Miceuz/leds-got-waxed/pics/20151221_044.jpg

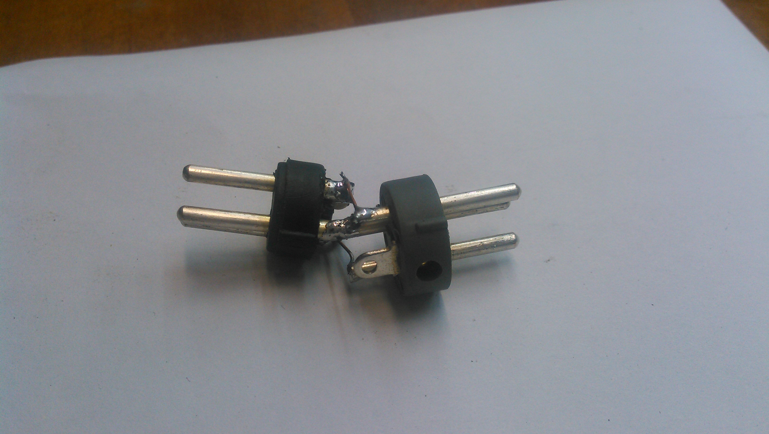
pics/20151221_044.jpg
