Miceuz/leds-got-waxed/20151120_155648.jpg

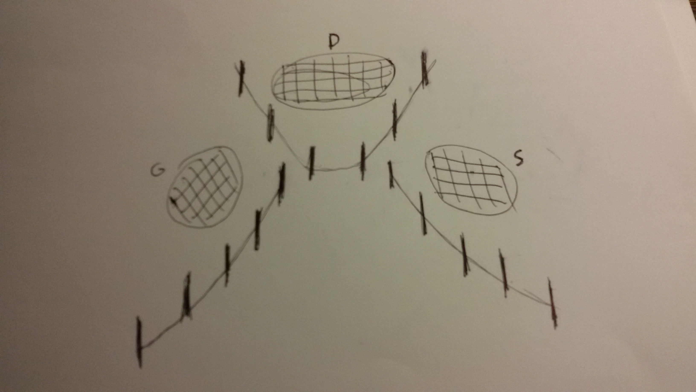
20151120_155648.jpg
