Miceuz/leds-got-waxed/README.md

# leds-got-waxed

A LED based effect box for a music band.
mess on a table

Full writeup is available here: http://wemakethings.net/2015/12/25/leds-got-waxed/
