Miceuz/leds-got-waxed/audio-channel.png

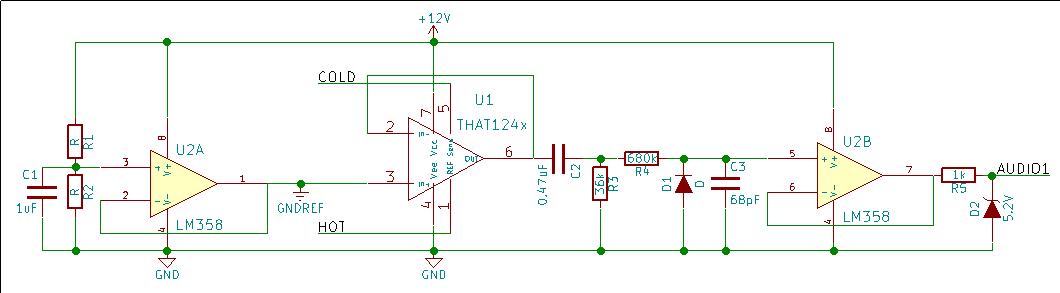
audio-channel.png
