Miceuz/leds-got-waxed/doc/PDS4.jpg

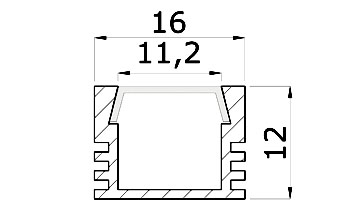
doc/PDS4.jpg
