Miceuz/leds-got-waxed/foot.png

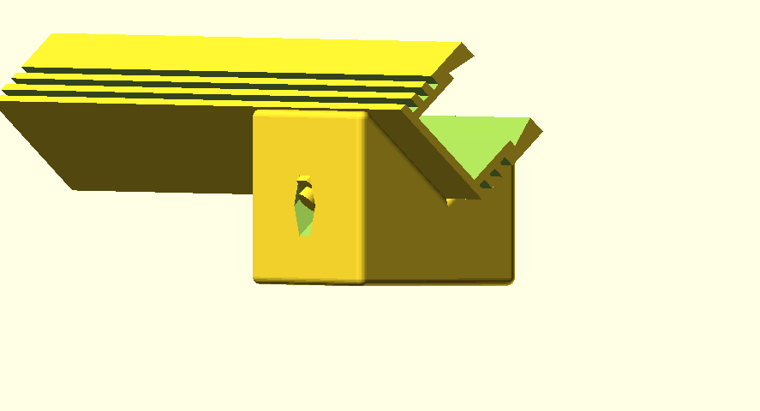
foot.png
