Miceuz/leds-got-waxed/multiplexer_cascade.png

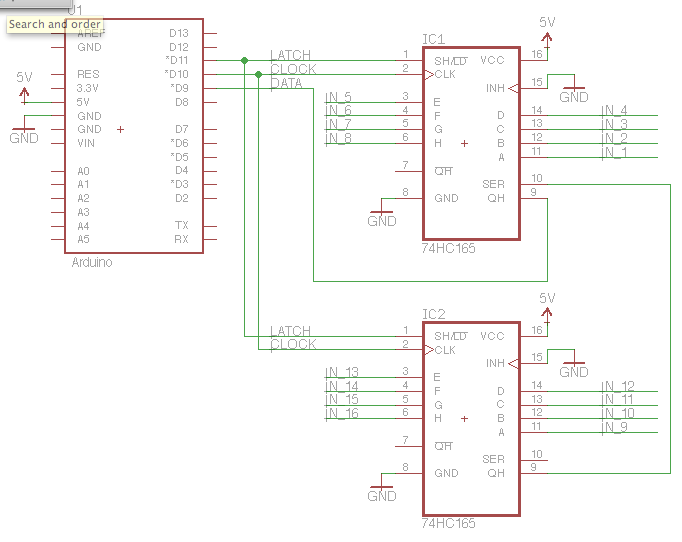
multiplexer_cascade.png
