Miceuz/leds-got-waxed/pics/20151221_002.jpg

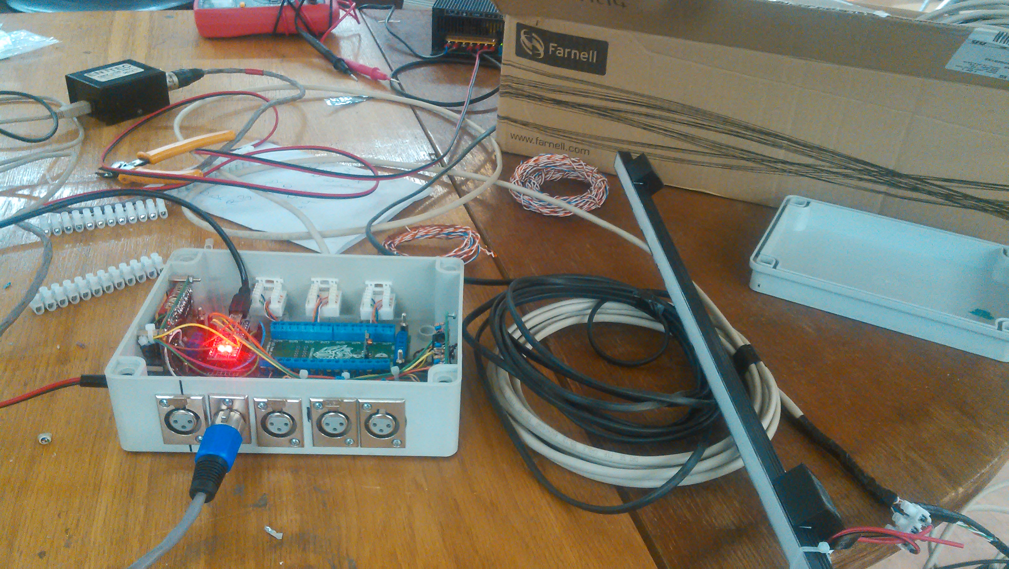
pics/20151221_002.jpg
