Miceuz/leds-got-waxed/pics/20151221_024.jpg

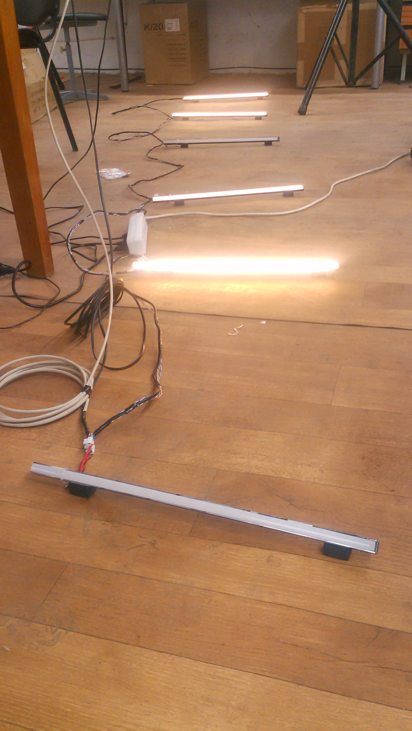
pics/20151221_024.jpg
