Miceuz/leds-got-waxed/pics/20151221_030.jpg

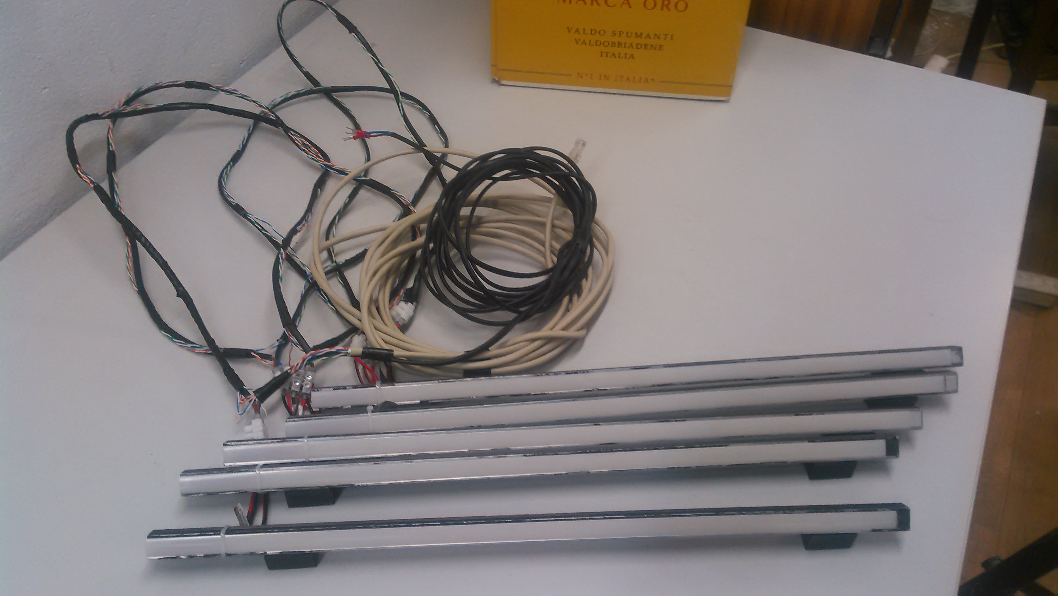
pics/20151221_030.jpg
