Miceuz/leds-got-waxed/pics/20151221_033.jpg

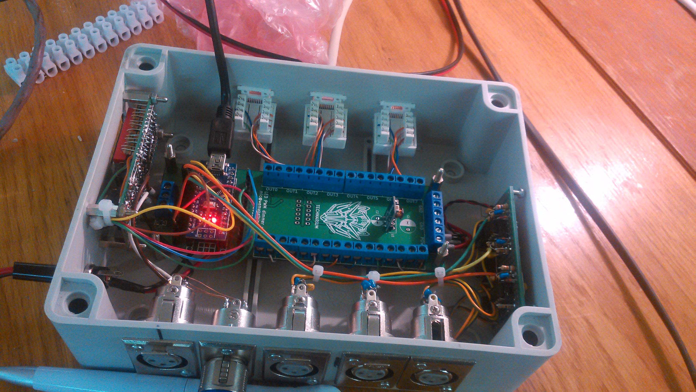
pics/20151221_033.jpg
