Miceuz/leds-got-waxed/pics/20151221_036.jpg

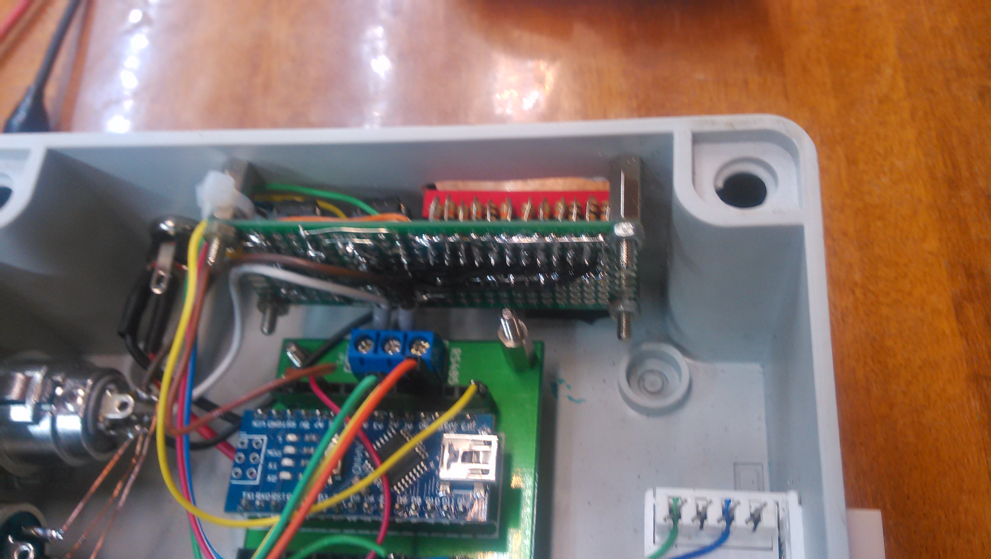
pics/20151221_036.jpg
