Miceuz/leds-got-waxed/pics/20151221_037.jpg

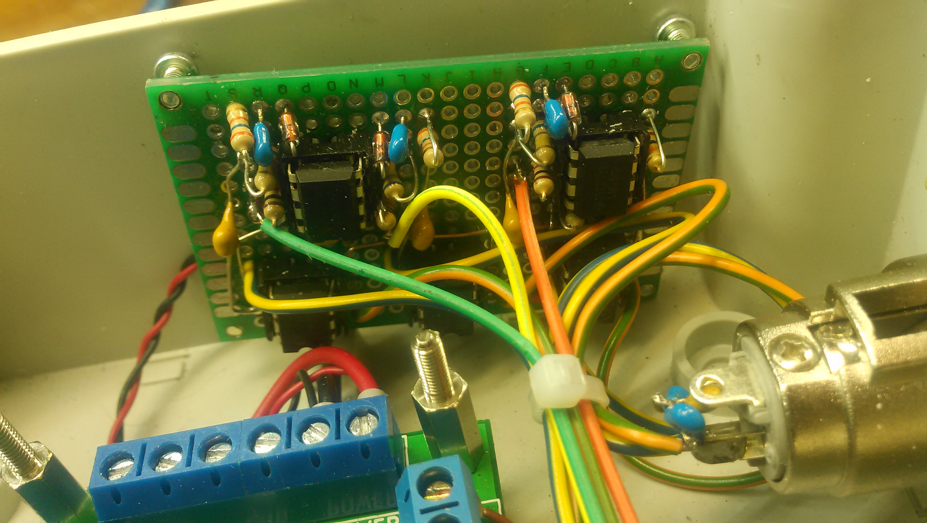
pics/20151221_037.jpg
