Miceuz/leds-got-waxed/pics/20151221_038.jpg

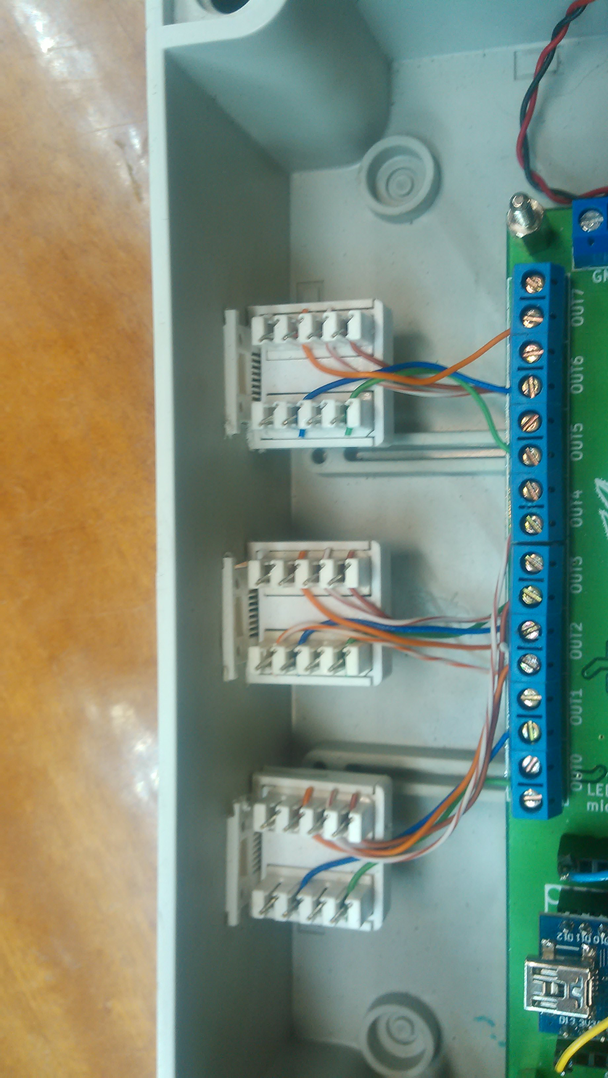
pics/20151221_038.jpg
