Miceuz/leds-got-waxed/pics/20151221_039.jpg

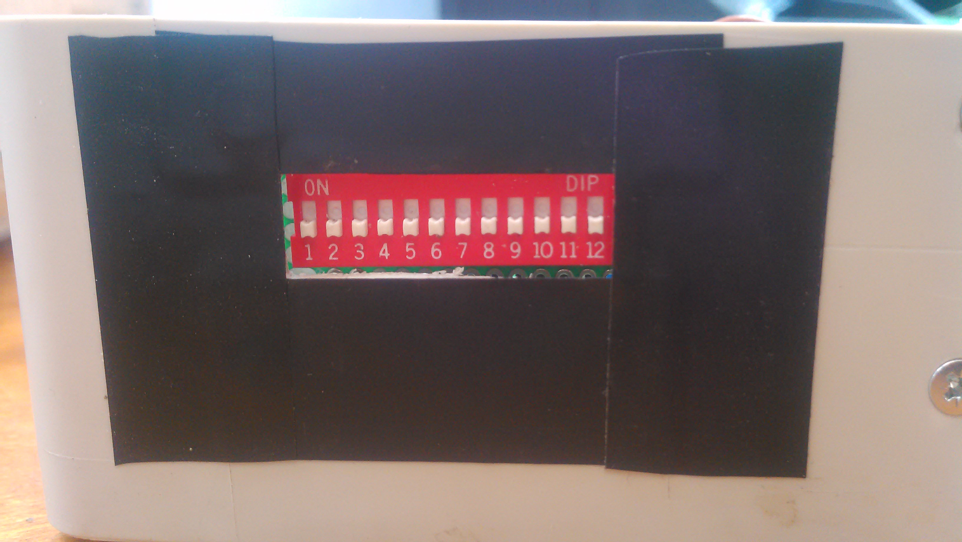
pics/20151221_039.jpg
