Miceuz/leds-got-waxed/pics/20151221_043.jpg

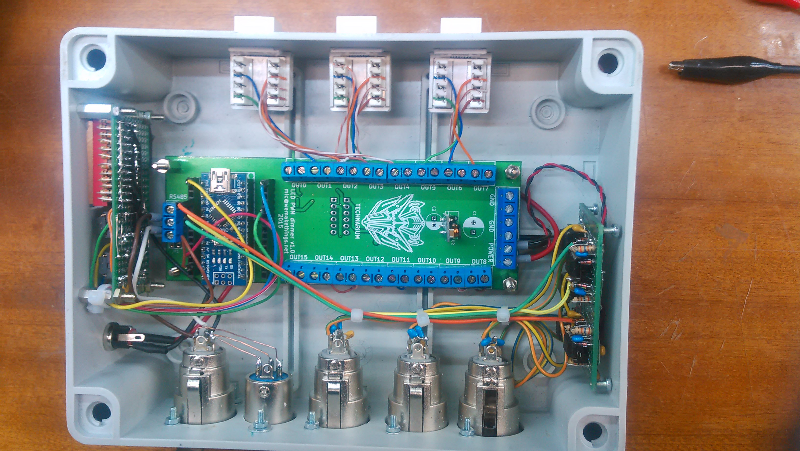
pics/20151221_043.jpg
