Miceuz/leds-got-waxed/pics/20151221_047.jpg

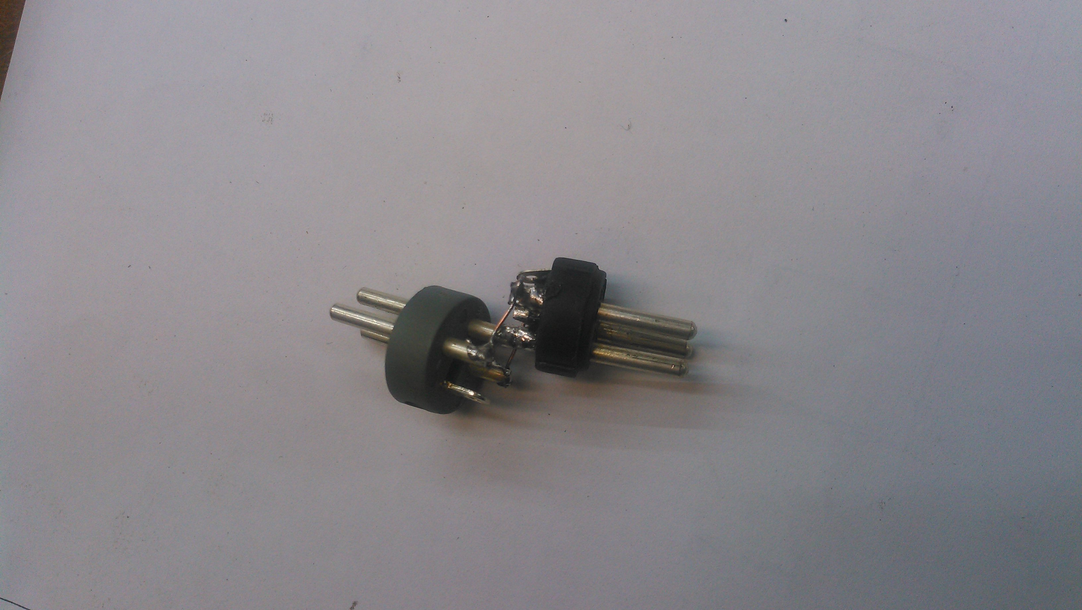
pics/20151221_047.jpg
