Miceuz/leds-got-waxed/pics/plug.jpg

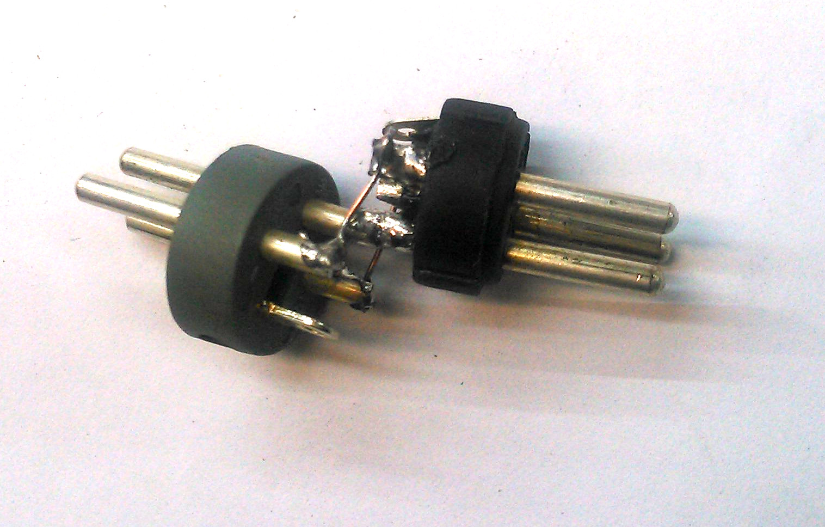
pics/plug.jpg
