Miceuz/leds-got-waxed/kojele.stl

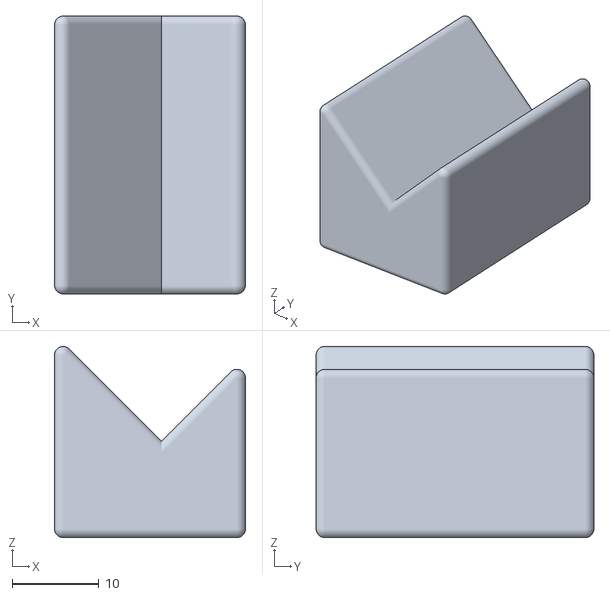
[picture p18: CAD file, 2015-12-12]
kojele.stl
22.0 x 32.0 x 22.0
