Miceuz/leds-got-waxed/leds-got-waxed/leds-got-waxed.kicad_pcb

## KiCad design ESP_Programmer/ESP_Programmer.kicad_pcb

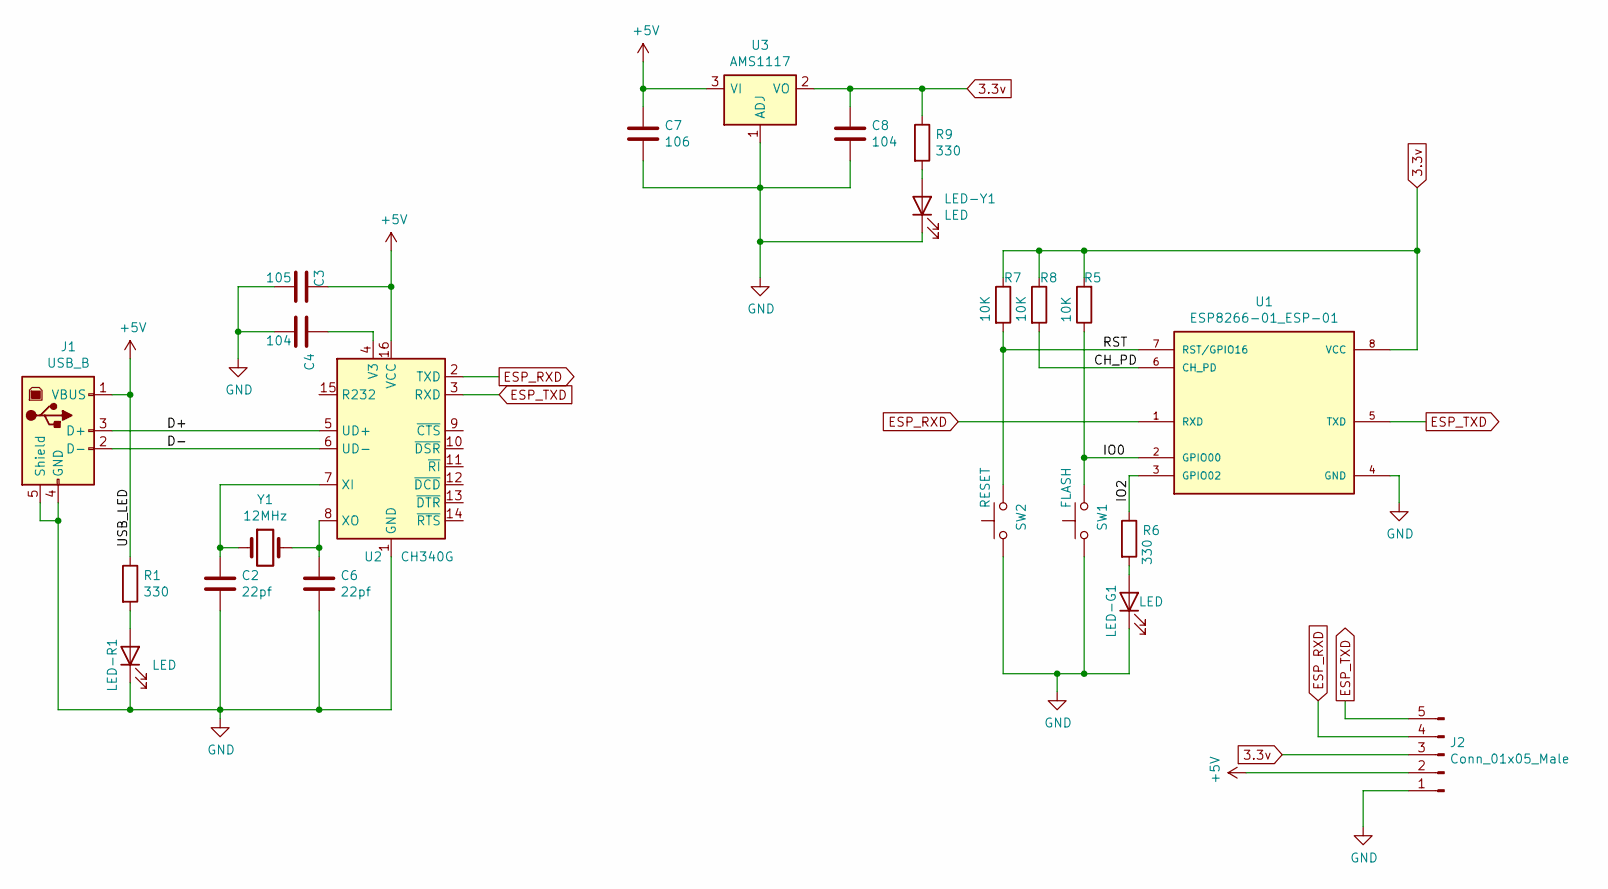
[picture p19: schematic ESP_Programmer.sch]

Parts:
C2, C6: 22pf; C_Disc_D3.8mm_W2.6mm_P2.50mm
C3: 105; C_Disc_D3.8mm_W2.6mm_P2.50mm
C4, C8: 104; C_Disc_D3.8mm_W2.6mm_P2.50mm
C7: 106; C_Disc_D3.8mm_W2.6mm_P2.50mm
J1: USB_B; USB_B_Lumberg_2411_02_Horizontal
J2: Conn_01x05_Male; PinHeader_1x05_P2.54mm_Vertical
LED-G1: LED; LED_D3.0mm_Clear
LED-R1: LED; LED_D3.0mm_Clear
LED-Y1: LED; LED_D3.0mm_Clear
R1, R6, R9: 330; R_Axial_DIN0207_L6.3mm_D2.5mm_P10.16mm_Horizontal
R5, R7, R8: 10K; R_Axial_DIN0207_L6.3mm_D2.5mm_P10.16mm_Horizontal
SW1: FLASH; SW_PUSH_6mm_H4.3mm
SW2: RESET; SW_PUSH_6mm_H4.3mm
U1: ESP8266-01_ESP-01; ESP-01
U2: CH340G; SOIC-16_3.9x9.9mm_P1.27mm
U3: AMS1117; SOT-223-3_TabPin2
Y1: 12MHz; Crystal_HC49-4H_Vertical

Connections:
3.3v: C8.1, J2.3, R5.2, R7.1, R8.1, R9.1, U1.8 (VCC), U3.2 (VO)
+5V: C3.1, C7.1, J1.1 (VBUS), J2.2, R1.1, U2.16 (VCC), U3.3 (VI)
/CH_PD: R8.2, U1.6 (CH_PD)
/D+: J1.3 (D+), U2.5 (UD+)
/D-: J1.2 (D-), U2.6 (UD-)
/IO0: R5.1, SW1.2, U1.2 (GPIO00)
/IO2: R6.1, U1.3 (GPIO02)
/RST: R7.2, SW2.2, U1.7 (RST/GPIO16)
ESP_RXD: J2.4, U1.1 (RXD), U2.2 (TXD)
ESP_TXD: J2.5, U1.5 (TXD), U2.3 (RXD); also elsewhere on the board
GND: C2.2, C3.2, C4.2, C6.2, C7.2, C8.2, J1.4 (GND), J1.5 (Shield), J2.1, LED-G1.1 (K), LED-R1.1 (K), LED-Y1.1 (K), SW1.1, SW2.1, U1.4 (GND), U2.1 (GND), U3.1 (ADJ); also elsewhere on the board
unnamed: C2.1, U2.7 (XI), Y1.1
unnamed: C4.1, U2.4 (V3)
unnamed: C6.1, U2.8 (XO), Y1.2
unnamed: LED-G1.2 (A), R6.2
unnamed: LED-R1.2 (A), R1.2
unnamed: LED-Y1.2 (A), R9.2

Board: 2 copper layers, 24 parts (0 on the bottom side), 17 nets, no tracks yet.

Other parts of the board:
R10: 10K; R_Axial_DIN0207_L6.3mm_D2.5mm_P10.16mm_Horizontal

Their connections:
ESP_TXD: R10.1; also elsewhere on the board
GND: R10.2; also elsewhere on the board
