Miceuz/leds-got-waxed/(commit log)

2015-12-23 Add AntiflashEffect, fix chase effect so that it does not overflow
    [Effect.cpp, Effect.h, wax.ino]
2015-12-24 Add multiplexer cascading schematics
2015-12-24 Make DipConfig work by bitbanging it. Clean up the code a bit. Add test mode detection on reset -- MSB on dip config
    [DipConfig.cpp, DipConfig.h, wax.ino]
2016-01-02 Make effects run backwards as this is more logical when keeping wiring in mind
